shakaman/cuckoo-clock/hardware/stl/gear_turntable.stl

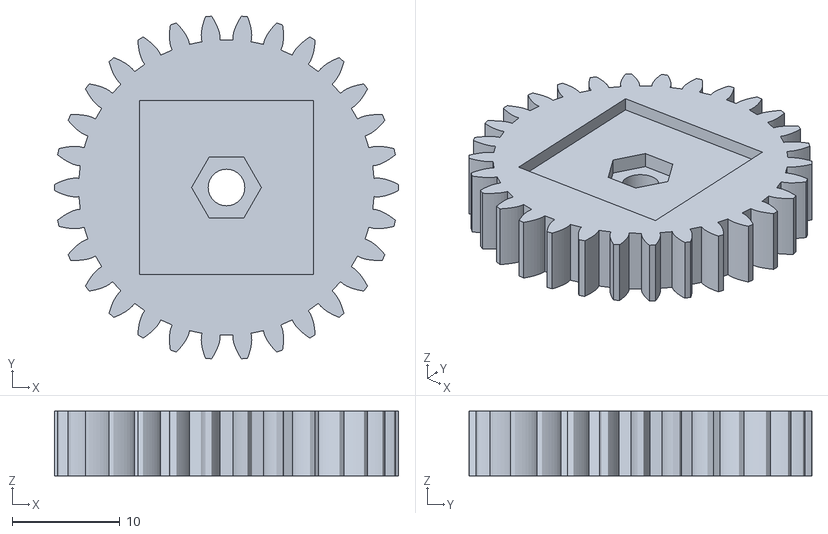
[picture p3: CAD file, 2026-11-07]
hardware/stl/gear_turntable.stl
32.0 x 31.9 x 6.00
