shakaman/cuckoo-clock/hardware/stl/door.stl

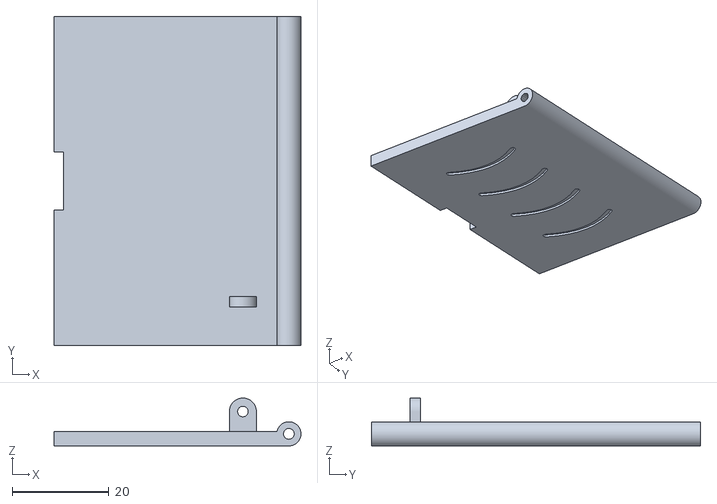
[picture p4: CAD file, 2026-11-07]
hardware/stl/door.stl
51.0 x 68.0 x 9.90
