shakaman/cuckoo-clock/hardware/stl/dial.stl

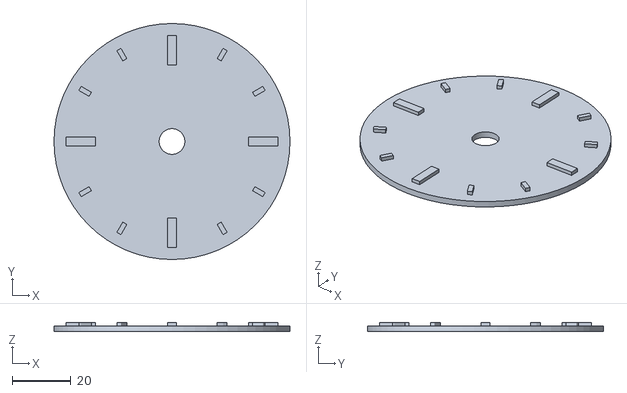
[picture p5: CAD file, 2026-11-07]
hardware/stl/dial.stl
80.0 x 80.0 x 3.20
