shakaman/cuckoo-clock/hardware/stl/carriage.stl

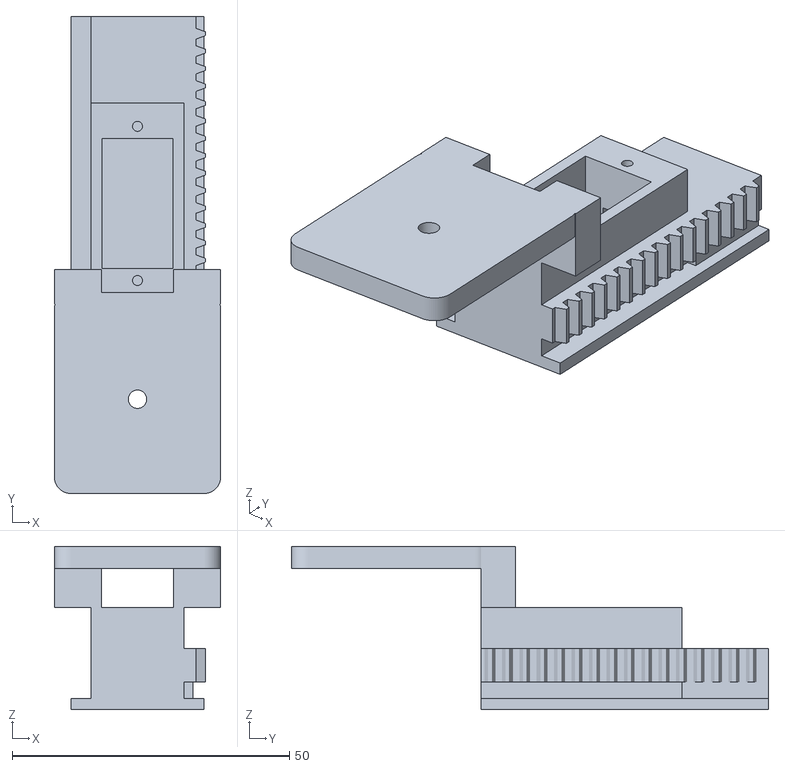
[picture p6: CAD file, 2026-11-07]
hardware/stl/carriage.stl
30.0 x 86.0 x 29.4
