shakaman/cuckoo-clock/hardware/stl/pinion.stl

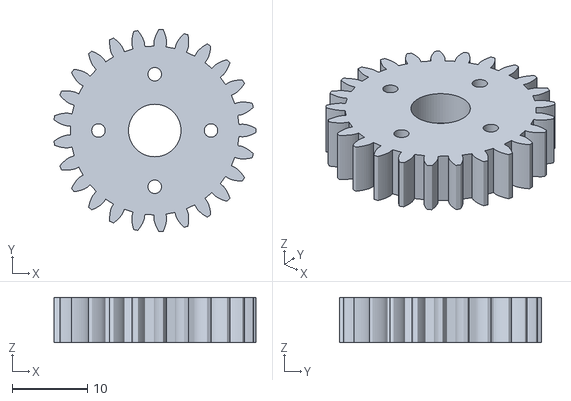
[picture p7: CAD file, 2026-11-07]
hardware/stl/pinion.stl
26.9 x 27.0 x 6.00
