shakaman/cuckoo-clock/hardware/stl/beak.stl

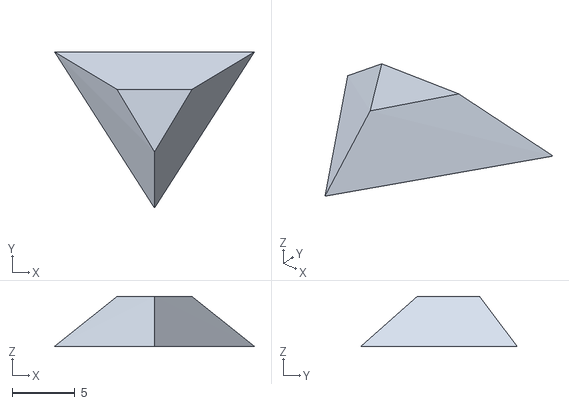
[picture p8: CAD file, 2026-11-07]
hardware/stl/beak.stl
16.0 x 12.5 x 4.00
