shakaman/cuckoo-clock/hardware/stl/button_cap.stl

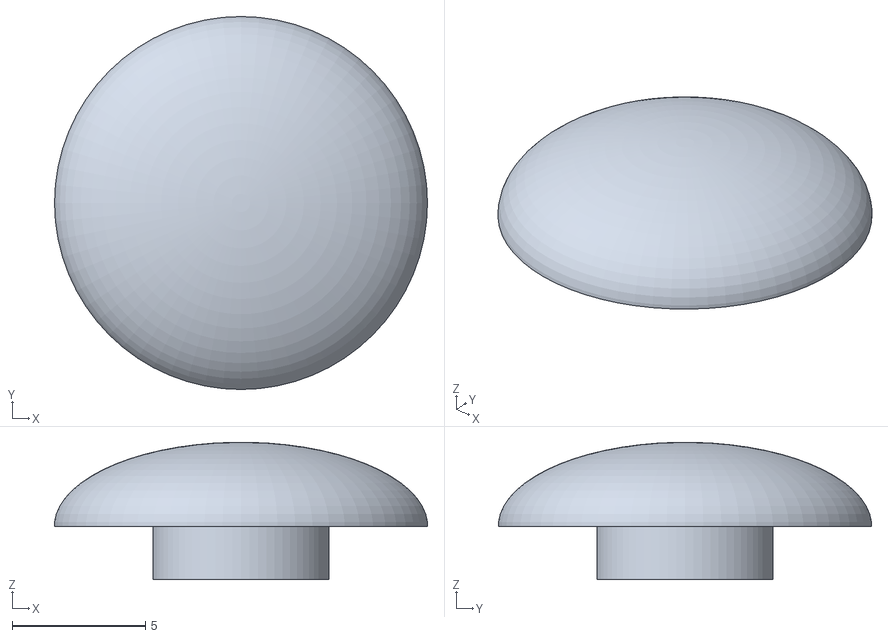
[picture p9: CAD file, 2026-11-07]
hardware/stl/button_cap.stl
14.0 x 14.0 x 5.15
