shakaman/cuckoo-clock/hardware/stl/deck.stl

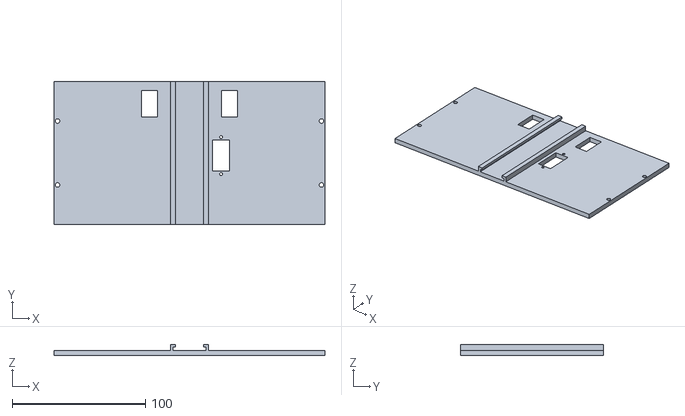
[picture p10: CAD file, 2026-11-07]
hardware/stl/deck.stl
203.4 x 107.0 x 8.40
