shakaman/cuckoo-clock/hardware/stl/door_crank.stl

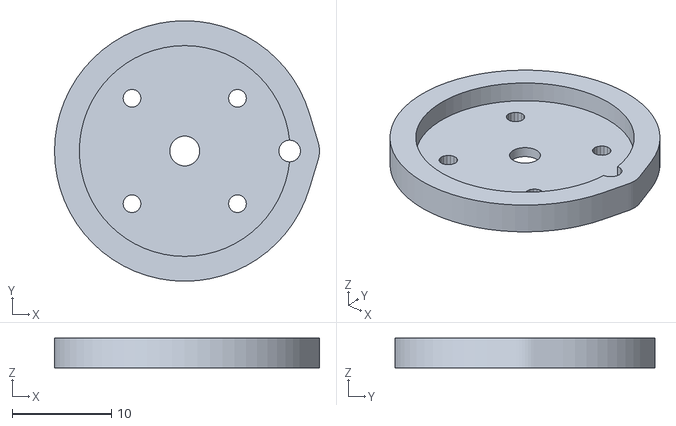
[picture p11: CAD file, 2026-11-07]
hardware/stl/door_crank.stl
26.7 x 26.2 x 3.00
