shakaman/cuckoo-clock/hardware/stl/door_link.stl

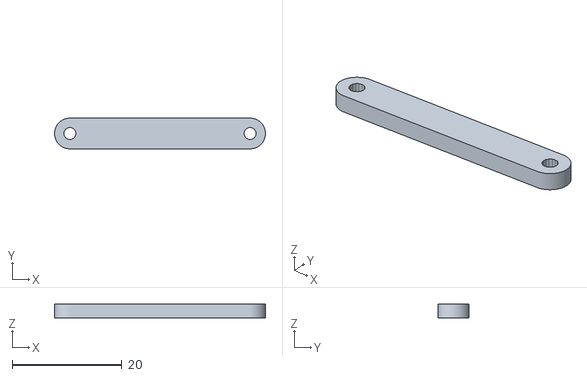
[picture p12: CAD file, 2026-11-07]
hardware/stl/door_link.stl
38.4 x 5.60 x 2.50
