shakaman/cuckoo-clock/hardware/stl/back_panel.stl

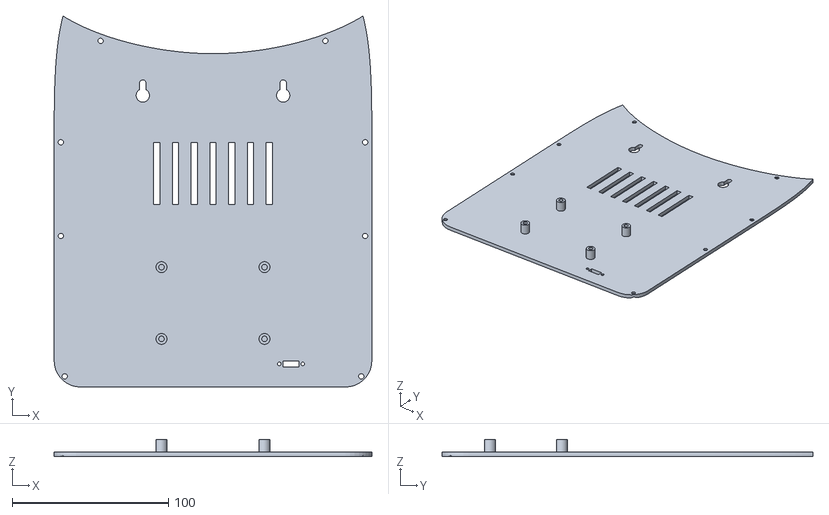
[picture p13: CAD file, 2026-11-07]
hardware/stl/back_panel.stl
203.6 x 237.7 x 11.0
