shakaman/cuckoo-clock/hardware/stl/face_mask.stl

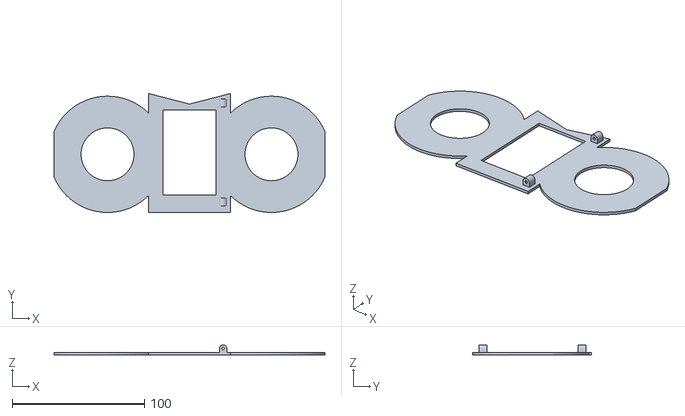
[picture p14: CAD file, 2026-11-07]
hardware/stl/face_mask.stl
205.0 x 90.0 x 7.90
