shakaman/cuckoo-clock/hardware/stl/gear_drive.stl

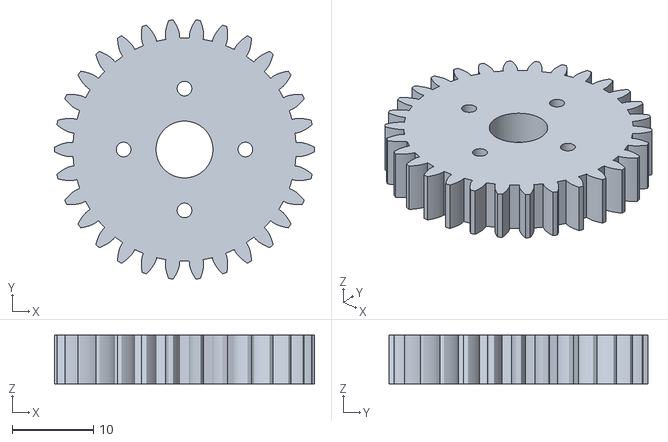
[picture p15: CAD file, 2026-11-07]
hardware/stl/gear_drive.stl
32.0 x 31.9 x 6.00
