shakaman/cuckoo-clock/hardware/stl/weight.stl

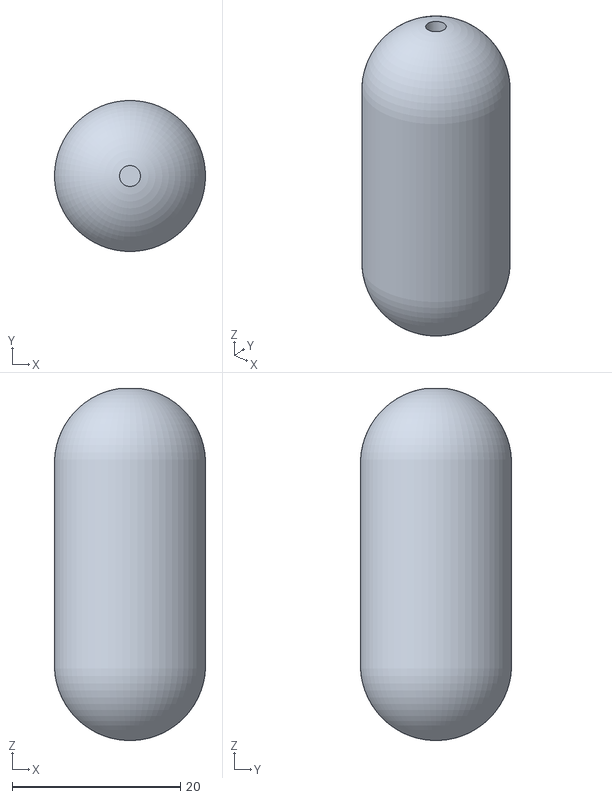
[picture p16: CAD file, 2026-11-07]
hardware/stl/weight.stl
18.0 x 18.0 x 41.9
