shakaman/cuckoo-clock/hardware/stl/body.stl

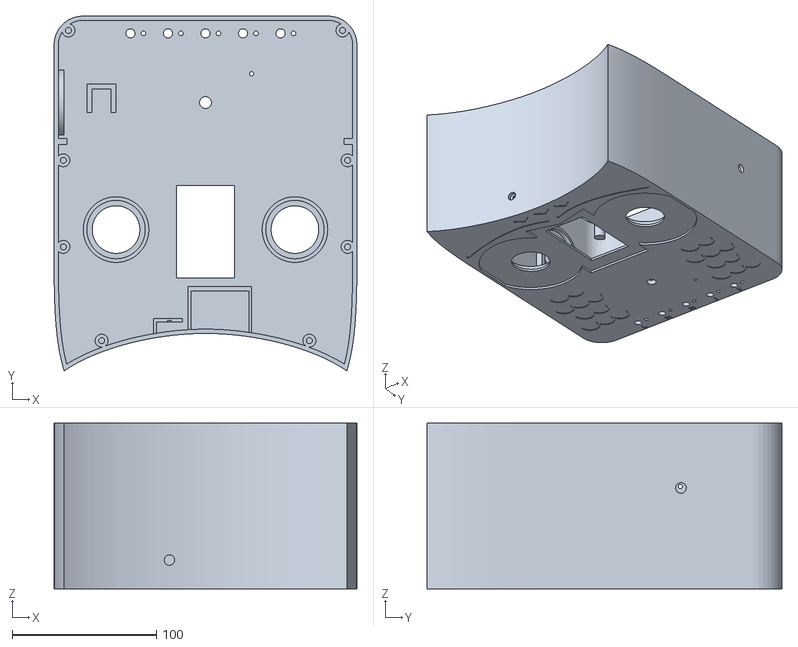
[picture p17: CAD file, 2026-11-07]
hardware/stl/body.stl
210.0 x 246.0 x 115.0
