shakaman/cuckoo-clock/(list of files, cad)

Other CAD files:
hardware/stl/pinecone.stl
