shakaman/cuckoo-clock/docs/front_template_1-1.pdf

## LEGO Cuckoo (owl) — front face 1:1

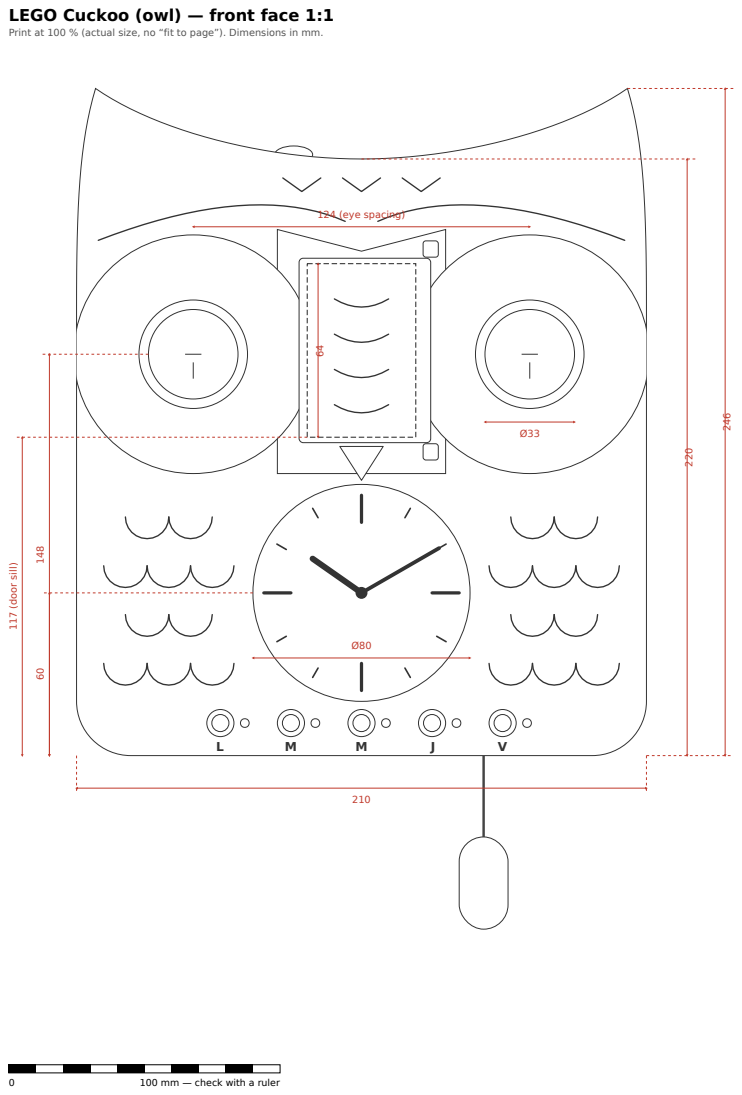
[picture p18: page 1]
124 (eye spacing); 117 (door sill); 100 mm — check with a ruler

Print at 100 % (actual size, no “fit to page”). Dimensions in mm.

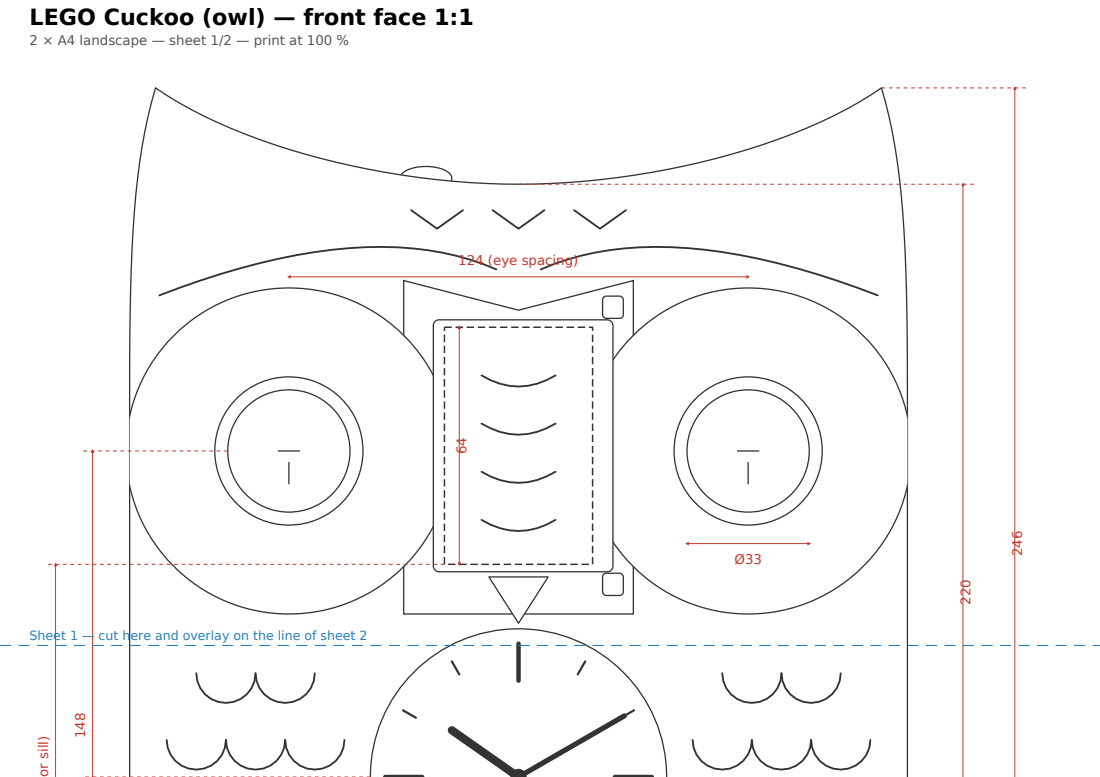
[picture p19: page 2]
124 (eye spacing); or sill)

2 × A4 landscape — sheet 1/2 — print at 100 %

Sheet 1 — cut here and overlay on the line of sheet 2

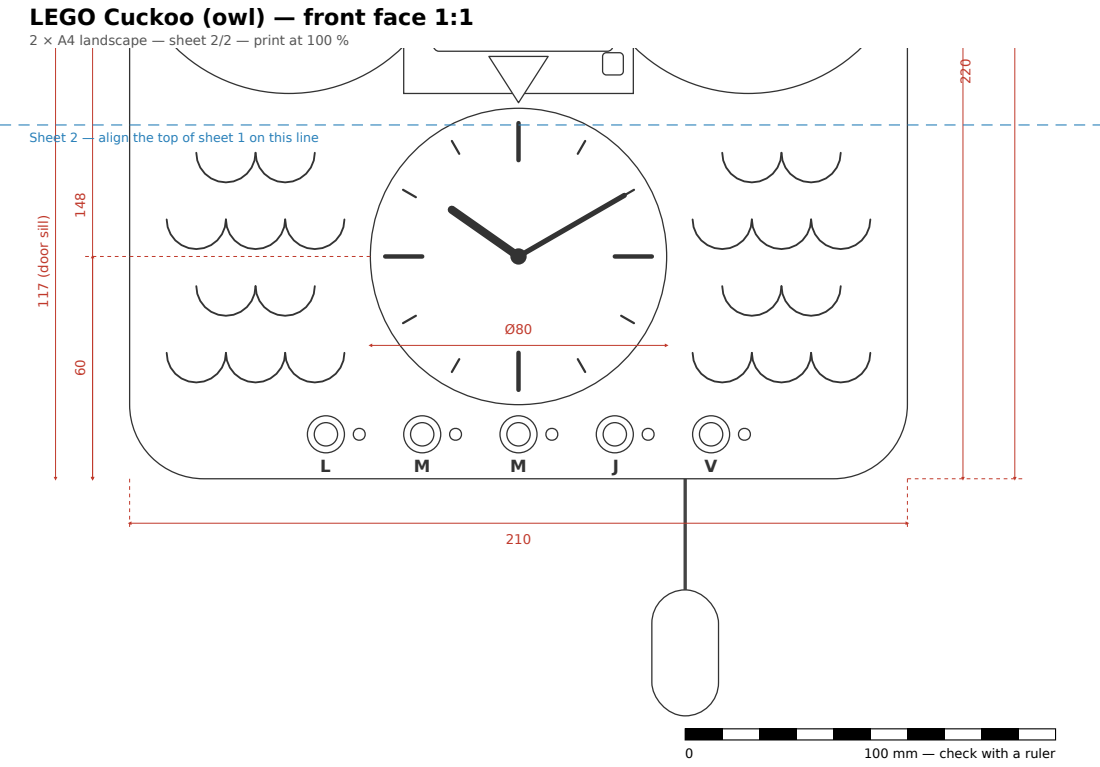
[picture p20: page 3]
117 (door sill); 100 mm — check with a ruler

2 × A4 landscape — sheet 2/2 — print at 100 %

Sheet 2 — align the top of sheet 1 on this line
