shakaman/cuckoo-clock/(commit log)

2026-11-07 Add enclosure & mechanism v0.2 (modern style)
    - Parametric OpenSCAD model (hardware/coucou.scad) and 20 print-ready STLs
    - Guillotine door, rack-driven carriage, rotating LEGO turntable
    - Hidden LD2410C presence radar (NFC dropped)
    - Renders, front view and 1:1 printable front-panel template (docs/)
    - README with features, BOM and ESP32-S3 pinout
    Claude-Session: https://claude.ai/code/session_01S21RAYg5epfTo2rrjXyk7g
    [back_panel.stl, body.stl, carriage.stl, chimney.stl, chimney_cap.stl, coucou.scad, deck.stl, dial.stl]
2026-11-07 Drive the quartz movement from the ESP32
    - Stepping quartz movement driven directly on GPIO 47/48
    - DRV5032 Hall sensor pocket behind the dial (12 o'clock, r=28) + wire hole
    - Magnet on the minute hand for hourly re-homing
    - README: timekeeping section, BOM and pinout updated
    Claude-Session: https://claude.ai/code/session_01S21RAYg5epfTo2rrjxyk7g
    [body.stl, coucou.scad, dial.stl]
2026-11-07 Translate repo to English and add agent context
    - READMEs, OpenSCAD comments, docs labels and file names in English
    (engraved L M M J V day labels stay French on purpose)
    - AGENTS.md with project context, invariants, pinout and firmware spec;
    CLAUDE.md imports it
    - tools/: interference check and front view / 1:1 template generators
    - .gitignore
    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
    [coucou.scad]
2026-11-07 Redesign as an owl head with a side-hinged door (v0.3)
    - One-piece owl shell (210 x 115 x 246) replacing body/gables/roof
    - Cream face mask inlay carrying the door hinge lugs, orange beak,
    engraved brows and feathers, top button instead of the chimney
    - Side-hinged overlay door driven by a parallelogram linkage from an
    upside-down servo above the opening (replaces the guillotine door,
    saves ~6 cm of height)
    - Collision check now sweeps the door 0-100°; new 3D render script
    - Front view, 1:1 template, READMEs and AGENTS.md updated
    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
    [back_panel.stl, beak.stl, body.stl, button_cap.stl, carriage.stl, chimney.stl, chimney_cap.stl, coucou.scad]
